SarahBlau/BME590-Flashlight-Project/Electronics/BME590electronicschematic.pdf

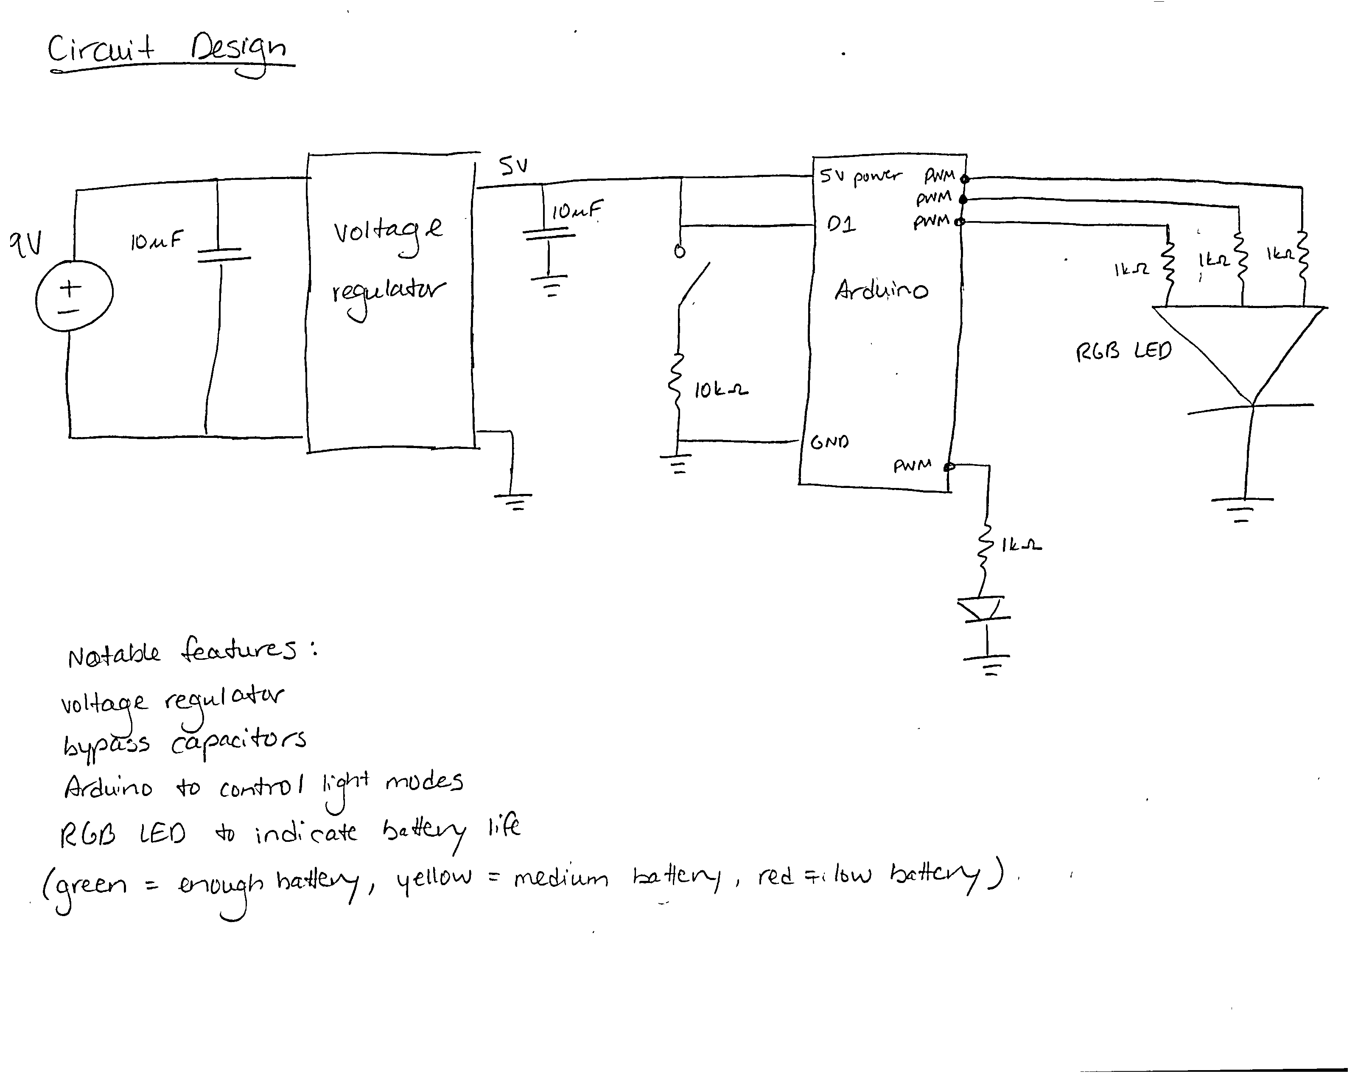
[picture p1: page 1]
