SarahBlau/BME590-Flashlight-Project/Software/BME590softwareflowchart.pdf

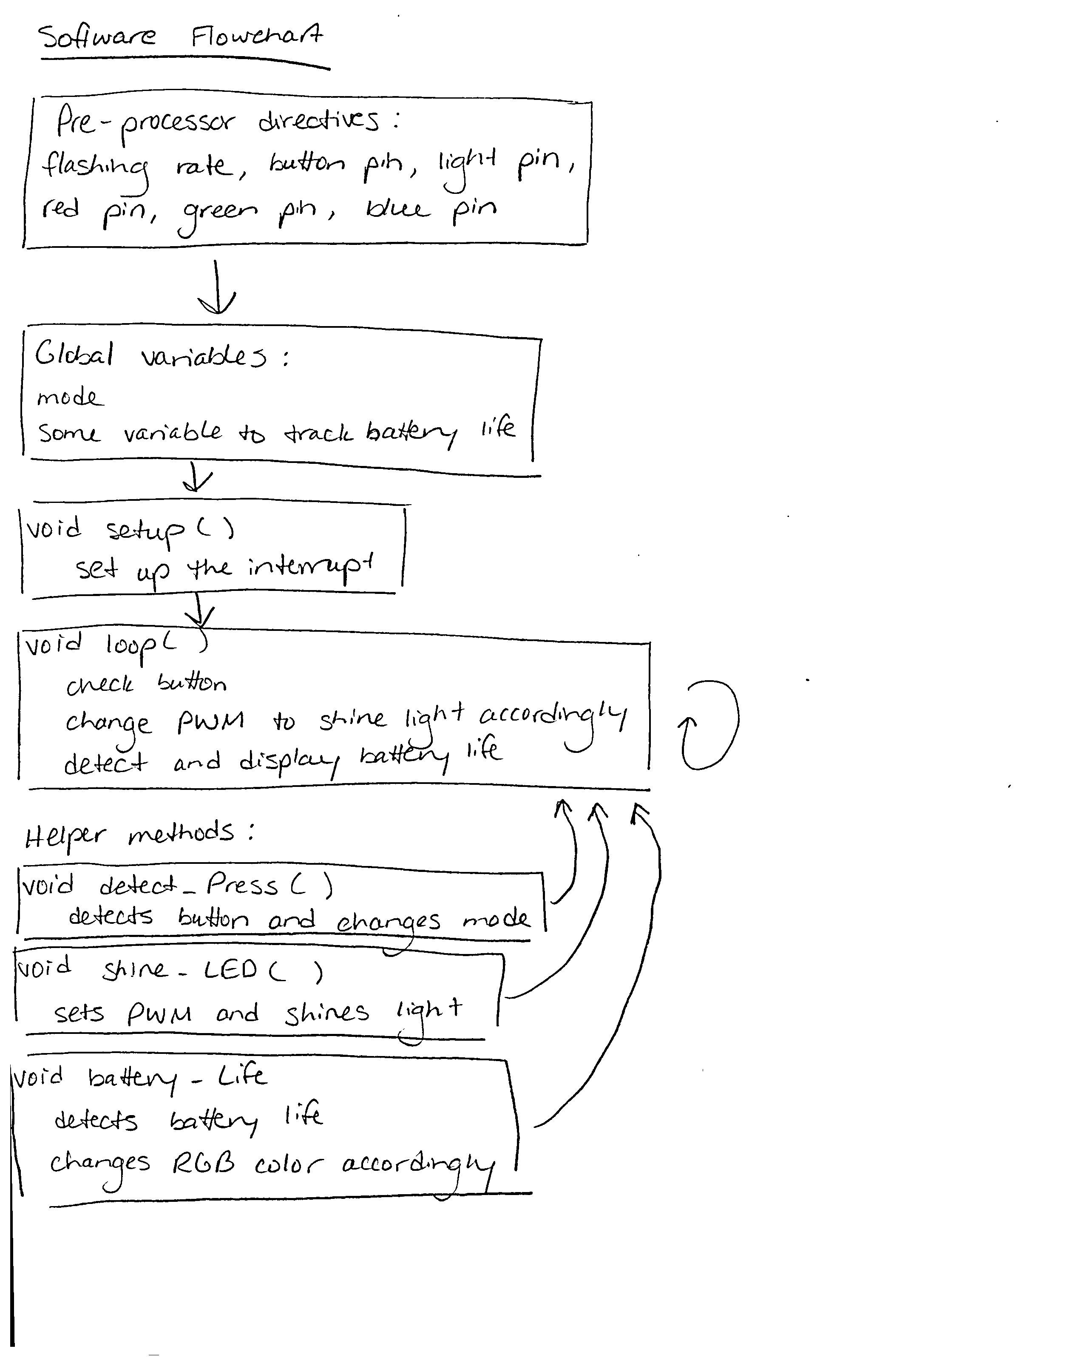
[picture p2: page 1]
