SarahBlau/BME590-Flashlight-Project/Mechanical/newboxtop v10.stl

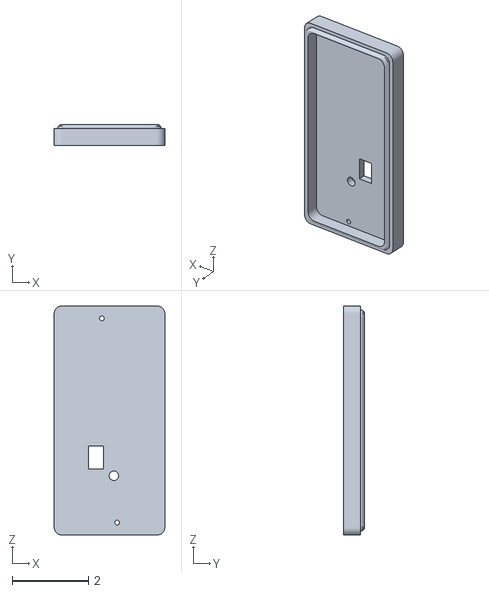
[picture p3: CAD file, 2018-12-09]
Mechanical/newboxtop v10.stl
2.90 x 0.55 x 6.00
