SarahBlau/BME590-Flashlight-Project/Mechanical/newboxbottom v7.stl

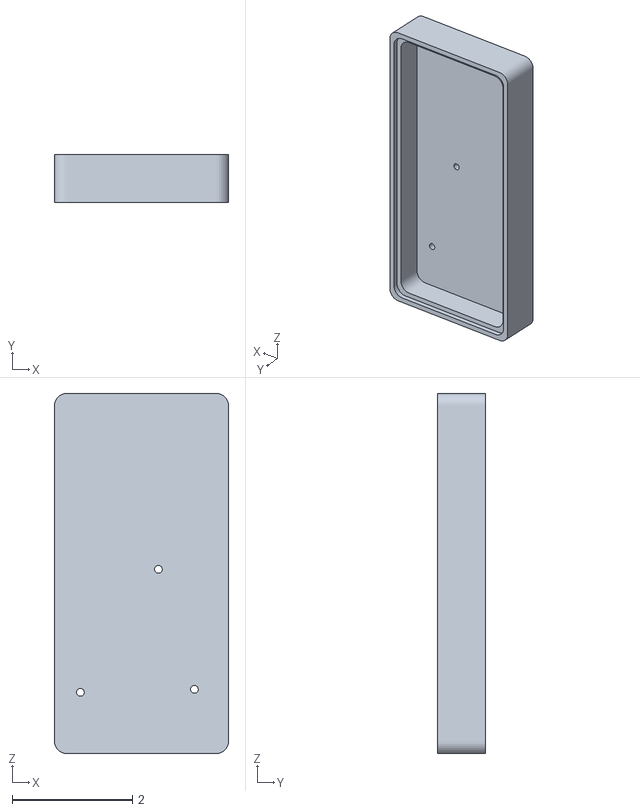
[picture p4: CAD file, 2018-12-09]
Mechanical/newboxbottom v7.stl
2.90 x 0.8 x 6.00
