SarahBlau/BME590-Flashlight-Project/Mechanical/newboxbottom v5.stl

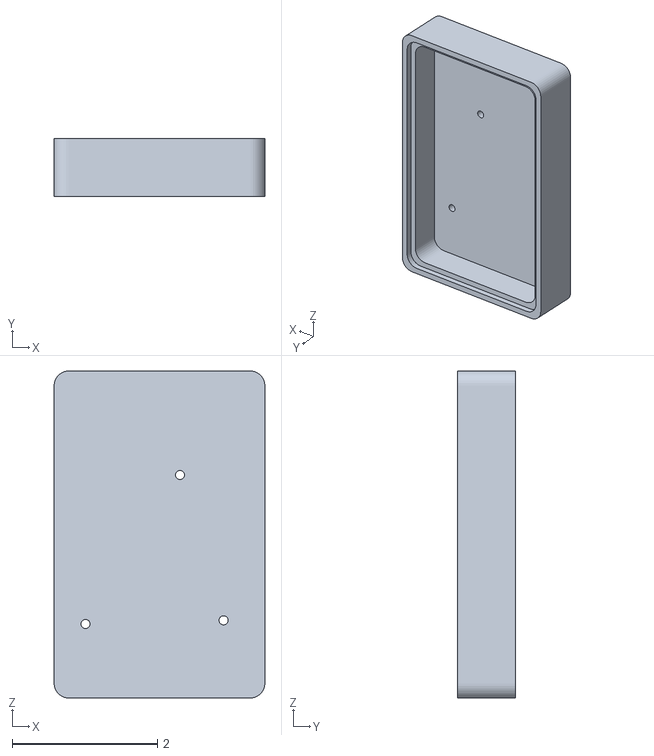
[picture p5: CAD file, 2018-12-06, an earlier design]
Mechanical/newboxbottom v5.stl
2.90 x 0.8 x 4.50
