SarahBlau/BME590-Flashlight-Project/Mechanical/newboxtop v6.stl

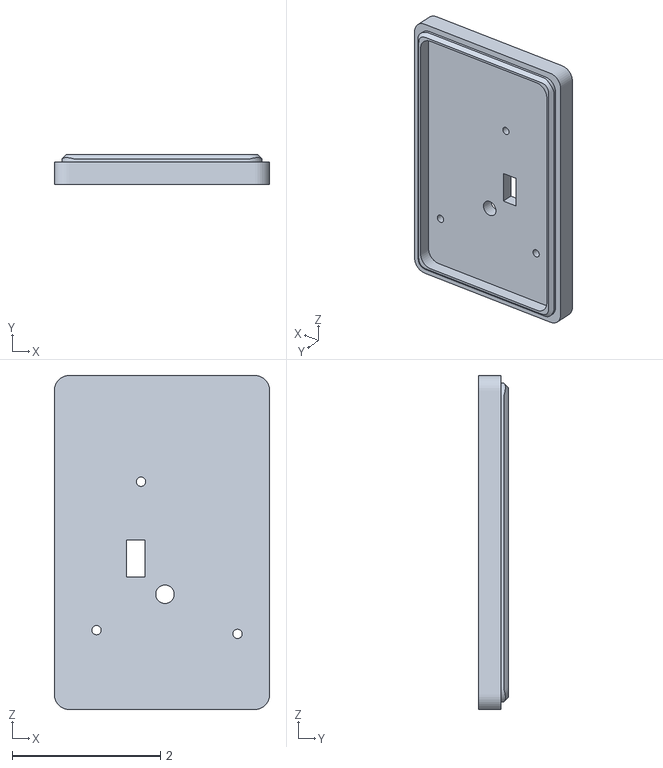
[picture p6: CAD file, 2018-12-06, an earlier design]
Mechanical/newboxtop v6.stl
2.90 x 0.4 x 4.50
