SarahBlau/BME590-Flashlight-Project/(list of files, cad)

Other CAD files:
Mechanical/BME590lightbox v3.f3d
Mechanical/BME590lightbox v6.f3d
Mechanical/buttonhat v3.f3d
Mechanical/newboxbottom v3.f3d
Mechanical/newboxtop v5.f3d
