SarahBlau/BME590-Flashlight-Project/Electronics/lightprojectPCBbrd.pdf

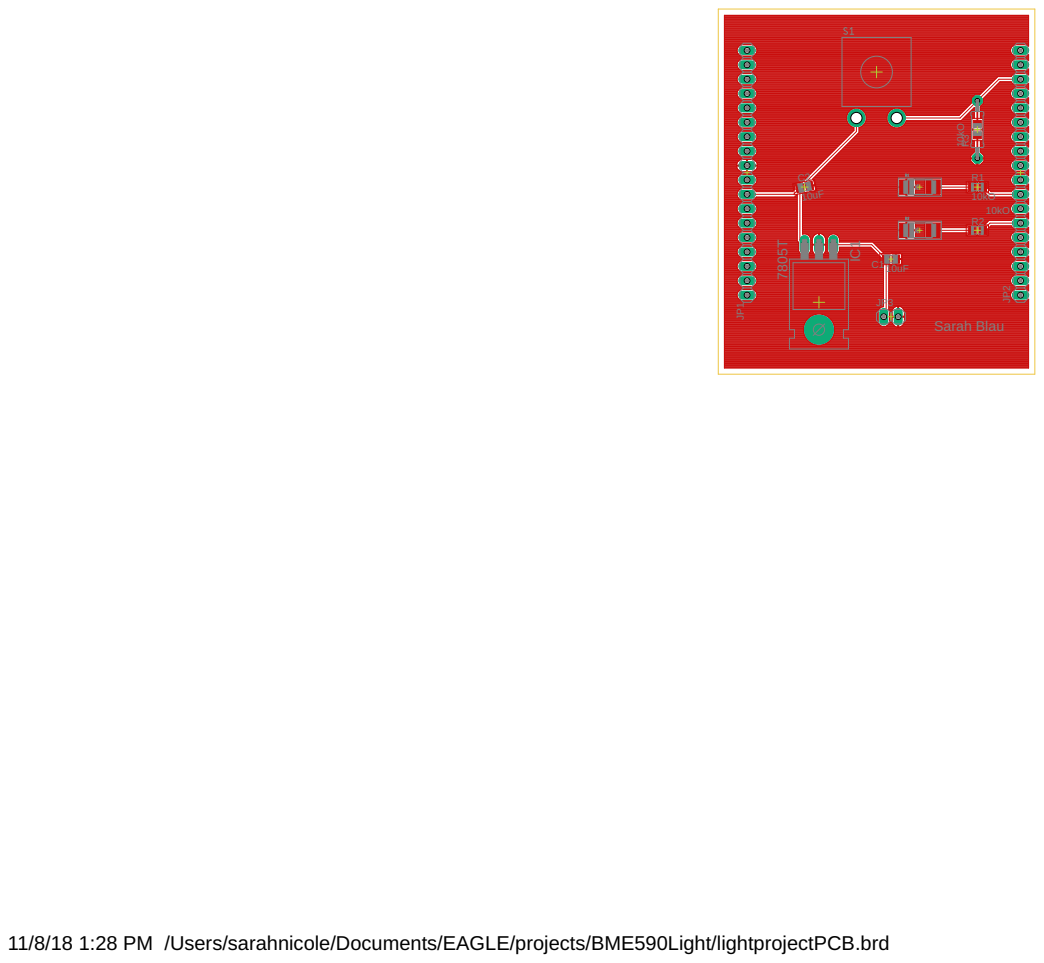
[picture p7: page 1]

11/8/18 1:28 PM /Users/sarahnicole/Documents/EAGLE/projects/BME590Light/lightprojectPCB.brd
