SarahBlau/BME590-Flashlight-Project/Electronics/lightprojectPCBsch.pdf

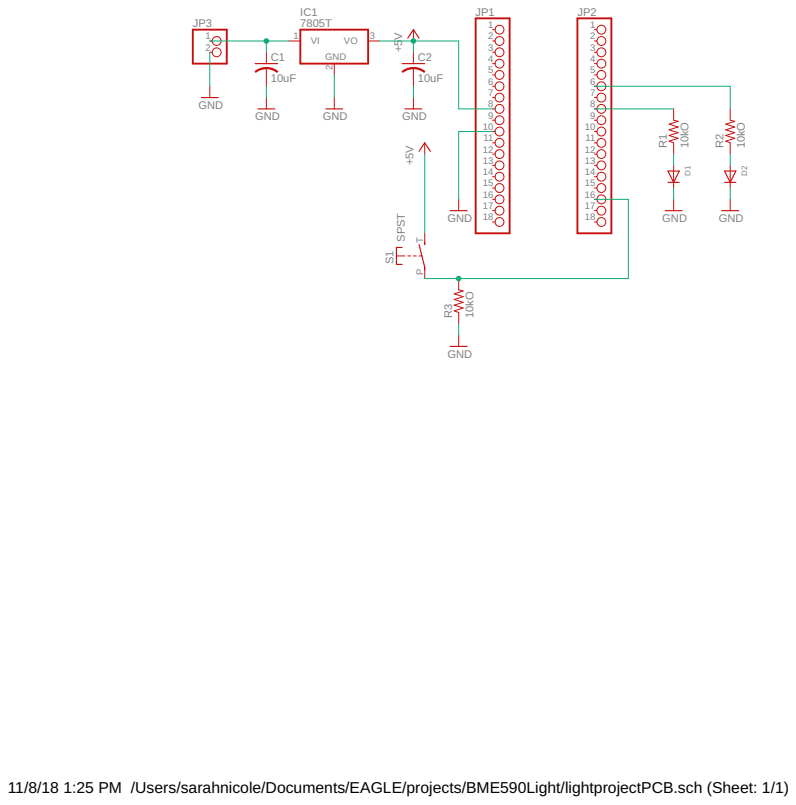
[picture p8: page 1]

11/8/18 1:25 PM /Users/sarahnicole/Documents/EAGLE/projects/BME590Light/lightprojectPCB.sch (Sheet: 1/1)
