SarahBlau/BME590-Flashlight-Project/Electronics/lightprojectPCB.brd

## EAGLE design Electronics/lightprojectPCB.brd (2018-11-30)

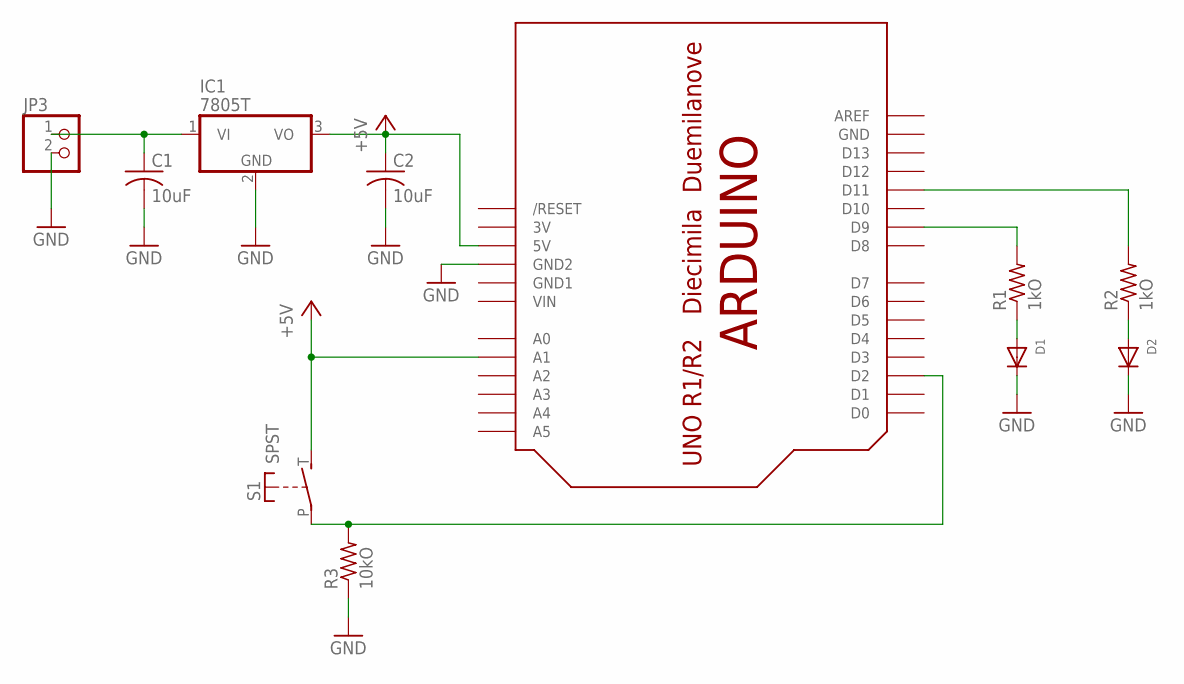
[picture p9: schematic lightprojectPCB.sch]

Parts:
C1, C2: 10uF; C0805
D1, D2: DIODESMA; SMADIODE
IC1: 7805T; TO220H
JP3: PINHD-1X2; 1X02
R1, R2: 1kO; M0805
R3: 10kO; M0805
S1: SPST; JUDCOSPST
U$1: ARDUINO-BPLACE

Connections:
3V: U$1.3V
+5V: C2.1, IC1.3 (VO), S1.T (S), U$1.5V, U$1.A1
GND: C1.2, C2.2, D1.C, D2.C, IC1.2 (GND), JP3.2, R3.1, U$1.GND, U$1.GND2
GND1: U$1.GND1
unnamed: R1.2, U$1.D9
unnamed: C1.1, IC1.1 (VI), JP3.1
unnamed: D2.A, R2.1
unnamed: D1.A, R1.1
unnamed: R3.2, S1.P, U$1.D2
unnamed: R2.2, U$1.D11
VIN: U$1.VIN

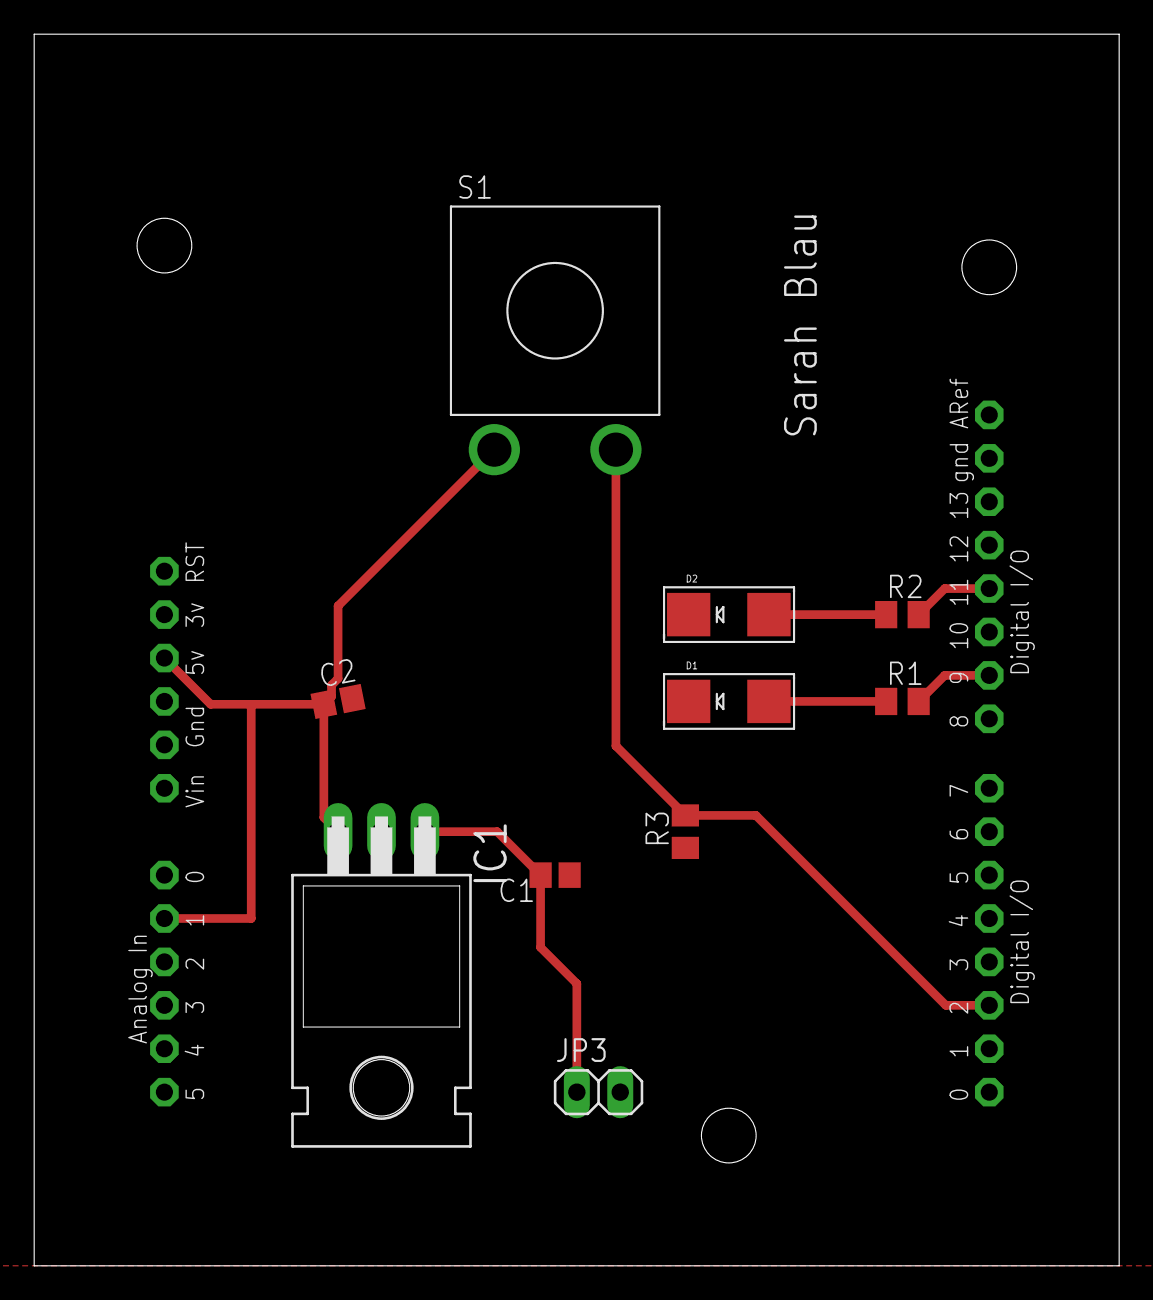
[picture p10: board lightprojectPCB.brd from above]

Board: 2 copper layers, 63.5 x 72.1 mm, 11 parts (0 on the bottom side), 8 nets.
