SarahBlau/BME590-Flashlight-Project/(threads)

Thread 3 (2018-10-02):

Closing issues?

SarahBlau, 2018-10-02:
I was trying to close the issue of the device diagram, and clicked on Archive but that made my card disappear.  Is there a way to recover it?  (I since found how to close an issue.)  Should we close issues once we finish them?  Or leave them open so we see them on the board?

mlp6, 2018-10-02:
You should be able to close an issue but leave it on the project board... archiving is one step beyond just closing.

Thread 4 (2018-10-02):

How to make the light flash with an analog circuit?

SarahBlau, 2018-10-02:
I overheard you telling someone that using the Arduino to code all the different settings might be a pretty big power drain, and battery life is something I'd like to prioritize in my design.  Is there a way to make an analog circuit that would make the light flash?

mlp6, 2018-10-02:
It might be tricky to make something that is purely analog... but there are ways to introduce some simple digital without throwing the 800 lb gorilla of an MCU at the problem.  (A teaser... I know.)

Thread 5 (2018-10-02):

Type of button

SarahBlau, 2018-10-02:
Does the button have to be the type of button that can only dictate whether or not an event has occurred?  Or could we use some sort of knob that could rotate between different functions of a circuit?

mlp6, 2018-10-02:
Button, not a knob!

Closed 2018-11-01.

Thread 9 (2018-11-03):

Button and lights at the top?

SarahBlau, 2018-11-03:
I'm anticipating that a "realistic" flashlight design would have the button and the light on the top of the device - would it be possible to mount the PCB close to the top of a box/enclosure?  Maybe by having a platform in the box where the PCB could sit?

mlp6, 2018-11-03:
Absolutely!

Thread 10 (2018-11-04):

PCB microcontroller

SarahBlau, 2018-11-04:
How do we know which microcontroller to put in our PCB design?  Is there a specific one or family of them that will correspond to the Arduino controller?

mlp6, 2018-11-04:
You will want to capture the header pins on your board, not the MCU itself.  To that end, you need to know the pin layout of the board you will be connecting to.

mlp6, 2018-11-04:
Most folks are using the Uno or the Nano.

Thread 12 (2018-11-06):

Milestone 3 review

SarahBlau, 2018-11-06:
Can you review my circuit and software flowchart please?

mlp6, 2018-11-06:
Looks good!  You may want to adjust the resistances driving the multi-color LED since the different colors may demand different voltages and you may want more consistent current draw for each color.

Your `D1` pin appears to always be attached to 5 V?

Software flowchart looks good!

Time for ECAD and coding!

Thread 14 (2018-11-08):

Milestone 4 release

SarahBlau, 2018-11-08:
PDFs have been uploaded!  I think I set the width of the routes to 12 mil, did I do this right?  I also was not sure how to move the origin back to the edge of the board.

sphaerobolus, 2018-11-12:
If we're photo-etching in house, we'll want 20mil traces.

C2 looks like the two terminals are shorted together.

It looks like you're trying to get this to attach as a shield to an UNO. The two rows of 0.1" spaced header pins won't connect to an UNO. The UNO's headers have a particular pin spacing to prevent mis-connections. Perhaps you can find a template to help you with the pin spacing.

10k current limiting resistors on the LEDs are probably excessive.
