SarahBlau/BME590-Flashlight-Project/(commit log)

2018-11-01 Add files via upload
    handwritten draft of schematic
2018-11-01 Add files via upload
    Handwritten flowchart
2018-11-08 Add files via upload
    First PDFs of ECAD schematic and PCB
2018-11-12 Add files via upload
    Original ECAD files (ie not PDFs)
    [lightprojectPCB.brd, lightprojectPCB.sch]
2018-11-24 Add files via upload
    Bare minimum code with debouncing but no battery life reading
2018-11-24 Add files via upload
    Updated schematic with Arduino footprint
    [lightprojectPCB.sch]
2018-11-26 Add files via upload
    Updated PCB, but need to redo polygon pour
    [lightprojectPCB.brd]
2018-11-26 Add files via upload
    Updated schematic and board to include an analog read of the battery voltage - still need to address polygon pour and make sure there are appropriate components in the lab for my design
    [lightprojectPCB.brd, lightprojectPCB.sch]
2018-11-26 Add files via upload
    Added battery read and display functionality
2018-11-27 Add files via upload
    Moved board back to origin, should be finalized
    [lightprojectPCB.brd]
2018-11-28 Add files via upload
    A very basic box
    [BME590lightbox v3.f3d]
2018-11-30 Add files via upload
    Shortened the board so it wouldn't hang over the Arduino on the edge where I need the ports to be accessible
    [lightprojectPCB.brd]
2018-11-30 Add files via upload
    Shortened box, added holes for power and USB
    [BME590lightbox v6.f3d]
2018-12-05 Add files via upload
    Corrected box and button extender
    [buttonhat v3.f3d, newboxbottom v3.f3d, newboxtop v5.f3d]
2018-12-05 Add files via upload
    Improved debounce, fixed battery detection
    [BME590light.ino]
2018-12-06 Add files via upload
    Fixed lip for putting lid on
    [newboxbottom v5.stl, newboxtop v6.stl]
2018-12-09 Add files via upload
    Longer box, deeper lid, started new attachment
    [newboxbottom v7.stl, newboxtop v10.stl]
2018-12-09 Add files via upload
    Fixed debouncing
    [BME590light.ino]
2018-12-11 Add files via upload
    Battery concept works
2018-12-11 Add files via upload
    PCB soldered correctly
